Elijah-GT/WorkWear/dashboard/floorplan.png

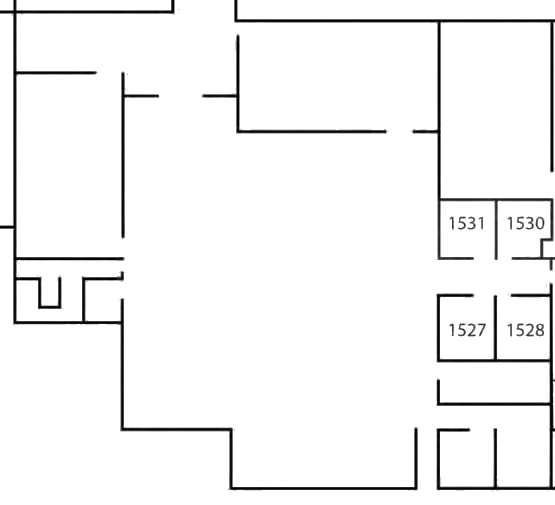
dashboard/floorplan.png
