Elijah-GT/WorkWear/firmware/secrets.example.h

// Copy this file to secrets.h and fill in the hotspot details.
// secrets.h is in .gitignore, so passwords stay out of git.
// The ESP32 only joins 2.4 GHz networks.
#pragma once

#define WIFI_SSID     "your-hotspot-name"
#define WIFI_PASSWORD "your-hotspot-password"
