Elijah-GT/WorkWear/(commit log)

2026-11-06 Add docs/PROTOCOL.md and settle open planning decisions
    - docs/PROTOCOL.md: full message spec for helmet, server, and dashboard
    (all routes, field types, fall-event retry/dedupe, heat-level bands).
    - Decisions: Python FastAPI + SQLite server; zone set per device on the
    dashboard (firmware sends zone: null); incidents snapshot the worker
    name; worn sensor with a worn=true fallback (A6 becomes stretch if cut).
    - PLAN.md: fill in the decisions table, add battery runtime and zone
    tasks, remove answered open questions.
2026-11-06 Set server build phases and fix protocol gaps
    - PLAN.md W4: server work split into phases S1-S5, each with a
    "done when" check; dashboard tasks start after S2. New risks: WSL2
    networking, Python 3.14 wheels, simulator data mixed with real data.
    - PROTOCOL.md: fall events get optional sent_uptime_ms, and "delayed"
    is based on it (the telemetry comparison failed while Wi-Fi was down).
    Devices with "sim-" IDs create incidents marked sample: true.
    - CLAUDE.md: a GPS fix adds lat/lon next to the zone, not instead of it.
2026-11-06 S1: server setup and SQLite database
    - server/: FastAPI app factory (create_app), SQLite schema for devices,
    telemetry, events, and incidents per docs/PROTOCOL.md, WAL mode,
    one connection per request, dashboard/ served at / once it exists.
    - Events are unique on (device_id, uptime_ms) so retried falls do not
    duplicate; incident type and status are checked in the schema.
    - Pinned requirements (fastapi 0.162.0, uvicorn 0.54.0, pytest 9.2.0,
    httpx 0.28.1); 7 tests pass on Python 3.14.
    - .gitignore (venv, caches, *.db) and .gitattributes (LF in the repo,
    which also renormalizes README.md).
    - PLAN.md: S1 ticked; findings on httpx deprecation and ROS PYTHONPATH.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
2026-11-07 S2: core API routes for telemetry, falls, devices, and incidents
    - POST /api/telemetry: creates new devices, stamps server time and the
    dashboard-assigned zone, drops lat/lon without a GPS fix.
    - POST /api/event: creates a fall incident with a worker-name snapshot,
    zone, GPS location from the latest fix, delayed and sample flags.
    Repeats (same device_id + uptime_ms) return the same incident, including
    two copies arriving at once (caught by the database unique key).
    - GET /api/devices: online within 5 s, latest reading, heat_level.
    - PATCH /api/devices/{id}: set name and/or zone; 404 for unknown devices,
    422 for empty names or unknown fields.
    - GET /api/incidents: newest first, stat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
2026-11-07 S4: fake-helmet simulator
    - server/simulator.py (standard library only): sim-01..sim-NN helmets
    send telemetry at 1 Hz, optional falls every N seconds, --heat-ramp,
    --resend (checks no duplicates), --duration, --seed. Falls that fail
    are retried every 2 s with sent_uptime_ms, like the firmware will.
    - NOAA heat index formula, tested against the NWS chart; PLAN.md W2 now
    points the firmware at it.
    - 89 tests pass. Live 32 s run: 3 online helmets, 1 sample incident,
    no duplicate on resend, 0 server errors.
2026-11-07 S3: manual reports, confirm/dismiss, and hazard counts
    - POST /api/incidents: injury or hazard reports from the dashboard; falls
    rejected (422); optional device_id must exist (404) and supplies the
    worker name when none is given; sim- devices give sample reports.
    - PATCH /api/incidents/{id}: set status and/or notes; only fields sent
    change; 404 for unknown ids.
    - GET /api/hazards: per zone, confirmed incident count, how many of those
    are sample data (new sample_count field), and the highest heat index;
    optional ?hours=N window. Zone-less data is left out.
    - PROTOCOL.md: sample_count and manual-report rules, with changelog.
    - 124 tests pass.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
2026-11-07 S5: server setup guide and README links
    - server/README.md: install (macOS/Linux/WSL/Windows), tests, running
    the server, the simulator and its options, reaching the server from
    the ESP32 (including WSL2 options), troubleshooting (ROS, ports, 422s).
    - README.md: "Start here" links to CLAUDE.md, PLAN.md, PROTOCOL.md, and
    the server guide.
    - PLAN.md: S5 ticked. Verified by following the guide in a fresh clone
    (install, 124 tests, server, 3 simulated helmets online). WSL2/firewall
    steps and the dashboard view are not yet tested.
2026-11-07 D1: dashboard skeleton with live counts and connection status
    - dashboard/: plain HTML/CSS/JS (ES modules), no build step, no internet
    needed. Served by the server at /. Refreshes devices and incidents every
    second; header shows Connected / Can't reach server (within 3 s).
    - Summary tiles: workers online, new incidents, recent incidents,
    simulated helmets. Footer states heat risk is ambient, location is
    simulated, and sim data is sample data.
    - zones.json: generic 2x3 grid (A1-A3, B1-B3).
    - logic.js with 4 node --test tests (package.json only sets ES modules;
    no dependencies).
    - Checked in headless Chrome with the simulator and with a server that
    stops answering. PLAN.md: dashboa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
2026-11-07 D2: worker cards with rename and zone picker; fix server threading bug
    Dashboard:
    - One card per helmet: name, online/offline, heat-risk color and reading,
    helmet on/off, last seen, simulated tag.
    - Rename in place (Enter saves, Esc cancels, empty names refused) and a
    zone picker that saves on change. Cards update in place so the 1 s
    refresh never wipes a name being typed or an open zone list.
    Server:
    - SQLite connections refused use from a second thread, and FastAPI can
    open a request's connection on one worker thread and run the route on
    another. Under parallel requests about 40% failed with 500, including
    helmet telemetry. Fixed with check_same_thread=False; regression tests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
2026-11-07 D3: incident list and fall alert banner
    - Newest-first incident list with status, "Sample data", and "Arrived
    late" badges; rows update in place.
    - Red banner for falls that arrive while the page is open. Falls already
    there on load, repeats, and manual reports do not alert. Stays until
    hidden; "+ N more" for several; tab title shows the count.
    - Optional alert sound, off until the supervisor clicks the button.
    - Layout: a long incident list no longer pushes the map down.
    Checked: banner 0.07-0.9 s after each simulator fall reached the server;
    22 scripted browser checks; 390 px phone width; 19 node tests.
2026-11-07 D4: site map with worker dots colored by heat risk
    - Zone grid built from dashboard/zones.json, labeled "Simulated
    location". One dot per helmet, colored by heat risk with the level in
    words too; legend; offline dots fade; per-zone worker count.
    - A worker with a new fall gets a red ring (and their zone) until the
    alert is hidden.
    - Workers with no zone or a zone not in the file are listed under
    "Not on the map". Bad zones.json entries are skipped and named.
    Checked in real time: a zone change on a worker card moves the dot in
    21-43 ms, one made through the API in 0.7-0.8 s; 21 scripted browser
    checks; 390 px phone width; 24 node tests.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
2026-11-07 D5: incident review, manual reports, and hazard/heat map layers
    - Incident rows: Confirm / Dismiss / Mark new and a notes editor that
    survives the 1 s refresh (Esc cancels, Ctrl+Enter saves). Confirming
    or dismissing a fall clears its alert.
    - "Report injury or hazard" form (type, zone, optional helmet or name,
    notes) posting to /api/incidents.
    - Map layers: Incidents shades zones by confirmed count from
    /api/hazards and says when counts include sample data; Heat colors
    zones by the highest heat index. Time window: all, 24 h, 8 h, 1 h.
    - PROTOCOL.md: note that the dashboard reuses the heat bands.
    A7 passes (simulator and test data). 31 real-time browser checks,
    390 px phone width,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
2026-11-07 F0: ESP32 firmware scaffold with on-helmet fall detection
    - firmware/ Arduino sketch: BNO085, BME280 (forced mode), NEO-6M GPS,
    optional worn sensor; heat index with the simulator's NOAA formula.
    - Fall state machine IDLE -> FREEFALL -> IMPACT -> STILL -> ALERT, all
    thresholds and pins in config.h. Worn flag latched at free-fall start.
    - Wi-Fi/HTTP on its own task: telemetry at 1 Hz, fall events sent at
    once and retried every 2 s with sent_uptime_ms (PROTOCOL.md 2.2).
    - LOG_CSV mode for threshold tuning; Wi-Fi details in git-ignored
    secrets.h; firmware/README.md with setup, wiring and first power-up.
    - PLAN.md: F0 entry, W3 CSV note, findings in section 8.
    Compiles for ESP32 (core 3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
2026-11-07 D7: room 1520 floor plan on the site map; distinct fall and hazard colors
    - dashboard/floorplan.png: the demo room's floor plan, with room names
    inside the zones and the outdoor labels removed.
    - zones.json now places zones as rectangles on the image (x, y, w, h in
    image pixels): 1520 West/North/South/Alcove, 1522, 1533. The old grid
    format still works when there is no image.
    - Colors: a new fall is a pulsing red outline plus a NEW FALL tag (never
    a fill); confirmed incidents are a red fill (1, 2, 3+) plus a count
    tag, so confirming a fall turns its zone red. Before, both were nearly
    the same pale pink. Heat layer tints whole zones. Zone key added.
    - Incident list and banner show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
2026-11-07 D8: GPS and beacon location, fall dots on the floor plan
    - Server picks a worker's zone in order: BLE beacon zone, then the zone
    the GPS fix falls in (gps_points in zones.json), then the dashboard
    zone. Each telemetry row and incident records zone_source.
    - New GET /api/site reports whether GPS-to-plan calibration is ready.
    - Dashboard draws falls as red dots: exact at the GPS spot, otherwise an
    approximate dashed dot in the zone. Located workers get a blue ring.
    - Firmware: optional BLE zone tracker (HAS_BLE_BEACONS, off by default)
    and a beacon sketch. Not yet tried on hardware.
    - Simulator: --beacon-zones and --gps options.
    - Tests: 165 server, 48 dashboard, 38 firmware.
    Co-Autho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
    [beacon.ino, beacons.cpp, beacons.h, config.h, fall_detector.cpp, fall_detector.h, firmware.ino]
2026-11-07 D9: dashboard tabs (Map, Workers, Incidents); map fits the window
    - One view at a time on every screen: tabs in the header, or a bar at
    the bottom on phones. Tab counts (online helmets, new incidents)
    replace the summary tiles.
    - The Map view sizes the floor plan to the window so the page does not
    scroll; the map key sits beside it on wide screens and folds away on
    smaller ones.
    - "Show in list" and fall dots switch to the Incidents tab.
    - Fix: the NEW FALL outline now uses the zone the fall happened in, not
    the zone a beacon-located worker has moved to since.
    - New README screenshots.
2026-11-07 D11: worker name tags always fit their zone
    - Each floor-plan zone checks whether its labels and name tags fit. If
    not, workers show as initials in their heat color (initials() in
    logic.js, tested); if even that does not fit, one "N workers" tag.
    Tags never spill into the next zone.
    - Clicking or tapping a worker dot opens the Workers tab with that
    card highlighted (phones have no hover for the full name).
2026-11-07 D12: dashboard layout restyle (rail, worker list, tables, pages)
    Layout only: colors, status colors and the API are unchanged. Layout
    ideas from screenshots of another product; no names, icons or assets
    copied.
    - Icon rail (Map, Workers, Incidents, Heat, Settings) and a searchable
    worker list with hard-hat avatars colored by status. Address-based
    pages (#/incident/<id>, #/worker/<id>) so Back works.
    - Slim one-line alert in the same fixed slot: worker, zone, time,
    peak g, other new falls, Show in list, hide.
    - Incidents table with status pills (Pending, Confirmed, Dismissed),
    status filter and View; one pill style and one type scale app-wide.
    - Incident page: mini map with the zone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
2026-11-07 F1: first hardware test; BNO085 is at I2C address 0x4B
    An I2C scan on the real board found the GY-BNO085 at 0x4B, so
    BNO085_ADDR is now 0x4B. With that the IMU reads OK (0.99 g at rest).
    The BME280 and the GPS sent nothing yet (not connected or not powered);
    Wi-Fi not tested. Findings recorded in PLAN.md.
2026-11-08 F2: bench wiring, USB serial bridge, IMU stall watchdog; first real fall on the dashboard
    - config.h: pins as wired (BNO085 SDA 21 / SCL 17 / RST 19 / INT 18; BME280 on
    Wire1 25/26, powered from GPIO27; GPS TX 23), build check against GPS/I2C pin clashes
    - SERIAL_BRIDGE + firmware/serial_bridge.ps1: a USB-connected helmet posts its
    telemetry and fall events to the server without Wi-Fi
    - sensors.cpp: restart the BNO085 if no accel data arrives for 1 s (it froze after a drop)
    - DROP_DEBUG: one diagnostic line per drop (turn off for the demo)
    - status line shows the IMU rate and gyro
    - server: covering index for /api/hazards (2.7 s to 0.35 s on 77k rows)
    - dashboard: hazards fetched on thei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
    [config.h, firmware.ino, sensors.cpp]
2026-11-08 D13: temperature as a per-worker reading only; no heat section
    - dashboard: SHOW_HEAT = false (logic.js) hides the Heat tab, heat map, heat index,
    humidity and heat colors; #/heat opens the map. Workers table gets an "Air temp"
    column and the worker profile shows air temperature only (not body temperature).
    Worker icons and map dots are colored by status (online, offline, new fall).
    - firmware: HAS_BME280 switch (on). With 0 the BME280 is not started and its fields
    are sent as null; the status line says "heat sensing off".
    - tests: heat-on cases pass heat=true explicitly; new heat-off test (60 pass)
    - CLAUDE.md / PLAN.md: decision recorded (Elijah, 2026-11-07); test drops #10, #11 di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
2026-11-08 F4: battery run; BME280 rejects impossible readings and restarts; drop check sent over Wi-Fi; air temperature in °F
2026-11-08 PLAN.md: tick finished hardware and firmware tasks, GPS dropped for the indoor demo, A4 reworded to air temperature
